TheWaveingOne/Projet-Final/Images/ard-dock-top.jpg

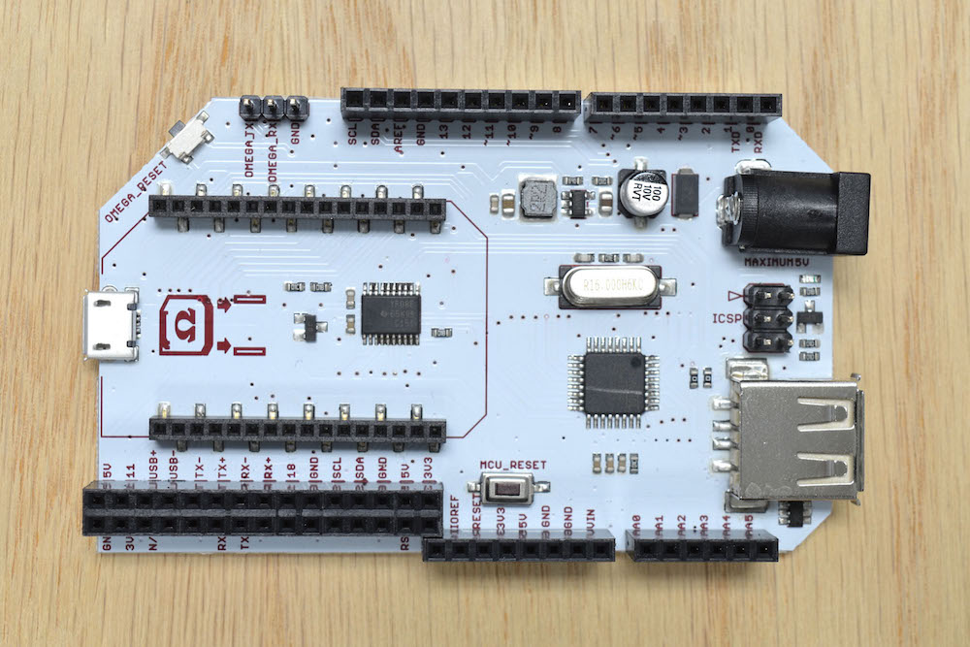
Images/ard-dock-top.jpg
