TheWaveingOne/Projet-Final/README.md

# Projet-Final
 Projet synthèse pour mon DEC
