TheWaveingOne/Projet-Final/PrésentationDessinMagnetique.pptx

## Contrôleur de dessin

Benoit Houle
Cegep de l’Outaouais
Technique du génie électrique
30 octobre 2019

## But

Remplacer le contrôleur
Changer la méthode de contrôle

## Utilités

Dessiner avec de l’encre magnétique
Linge avec lumières
Test sur du papier (plus rapide)

## Fonctionnalités

Contrôle de trois moteurs
Lecture de trois capteurs
Dessiner

## Exigence

Connexion réseau (wifi)
Doit pouvoir fonctionner sans surveillance
Alerte sonore quand la tâche est complété

## Contrainte

Milieu scolaire (bruit minimum)

Simplicité d’utilisation
