TheWaveingOne/Projet-Final/Eagle/CAM/Commandes.png

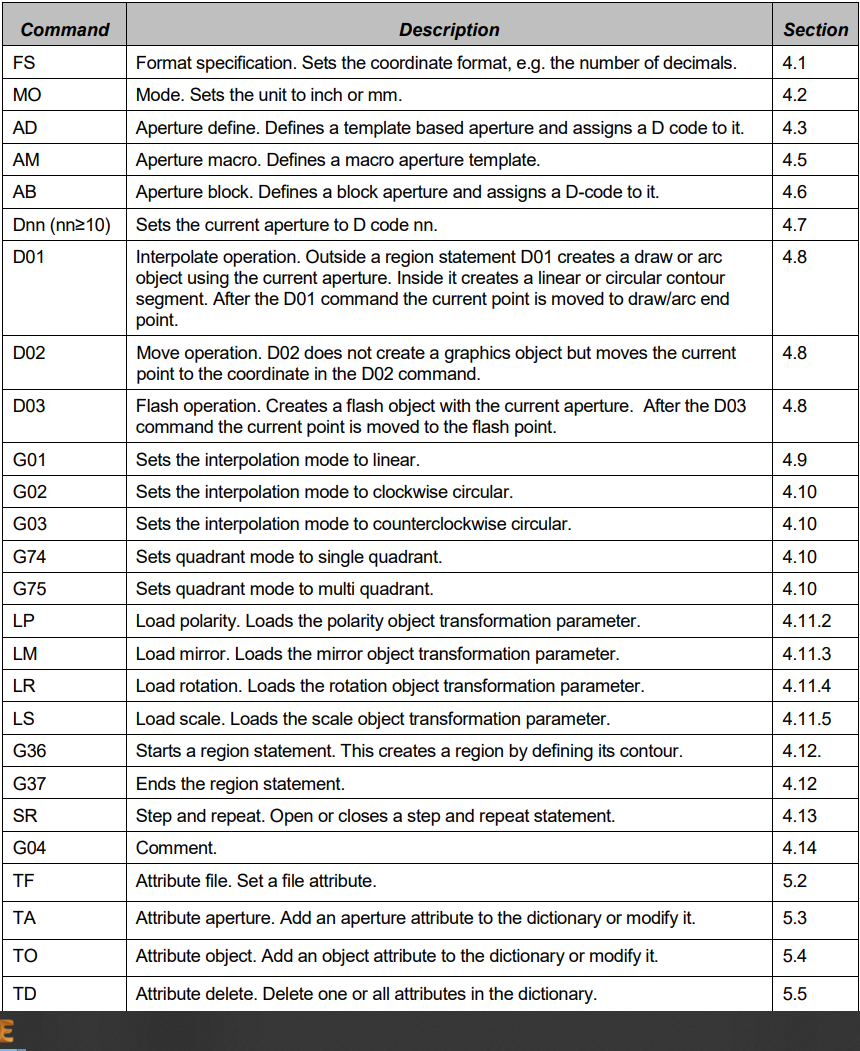
Eagle/CAM/Commandes.png
