TheWaveingOne/Projet-Final/Eagle/Controle_Des_Moteurs.png

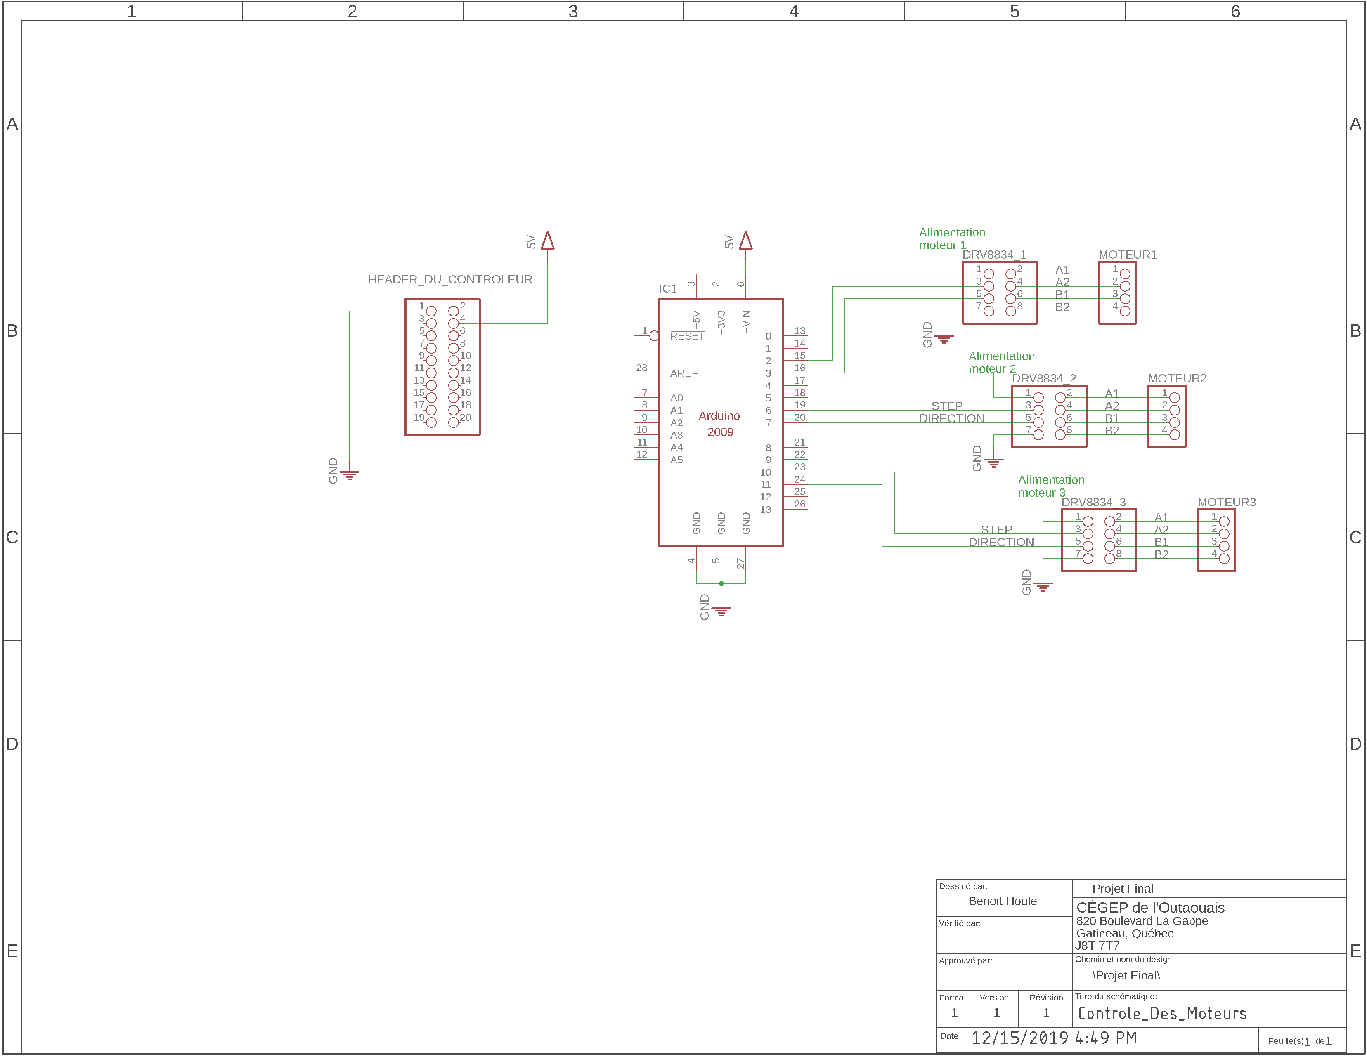
Eagle/Controle_Des_Moteurs.png
