TheWaveingOne/Projet-Final/Images/DRV8834 board pin.png

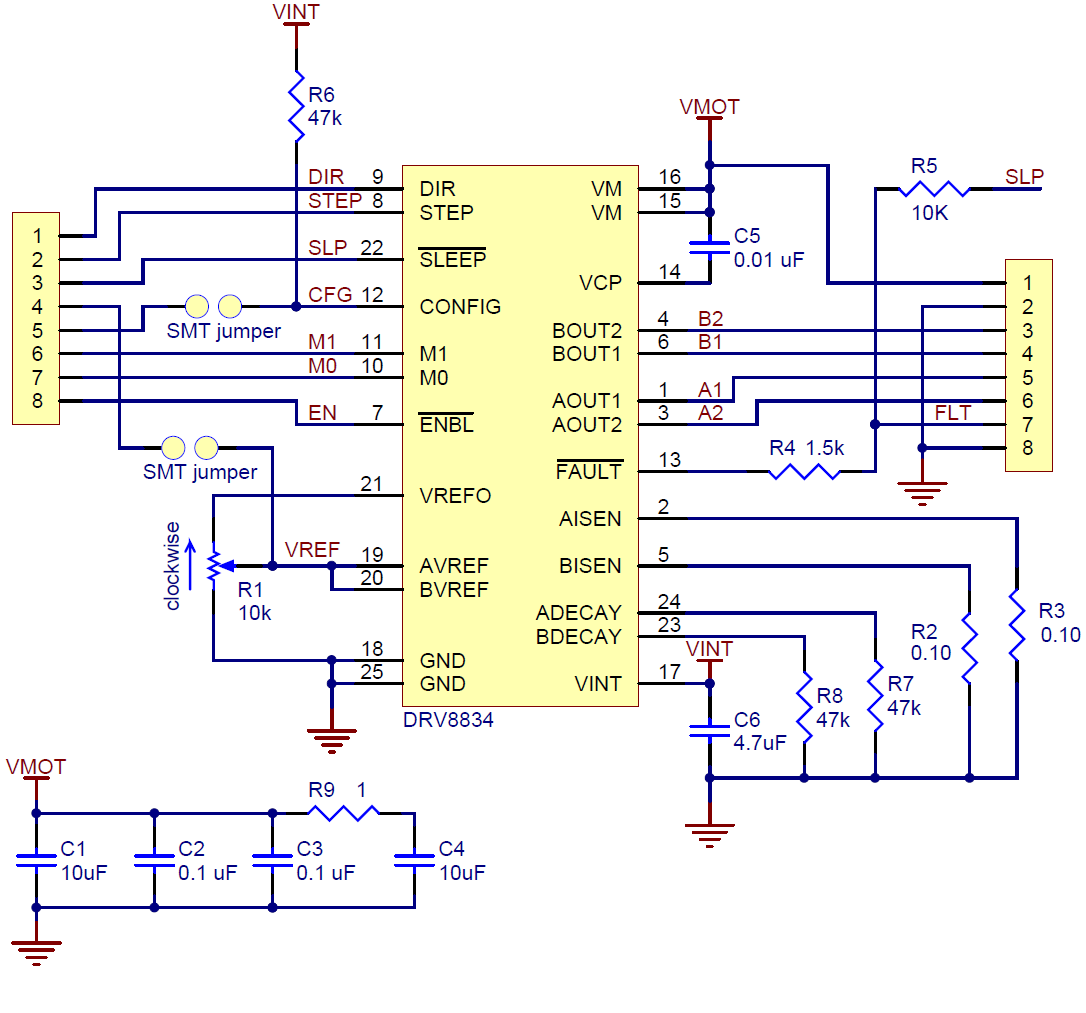
Images/DRV8834 board pin.png
