TheWaveingOne/Projet-Final/Images/DRV8834 exemple pin2.png

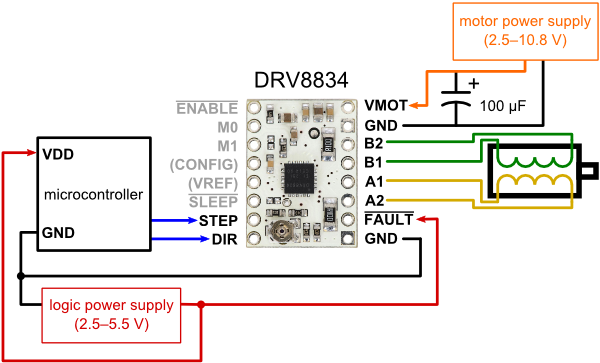
Images/DRV8834 exemple pin2.png
