TheWaveingOne/Projet-Final/Images/schematique.png

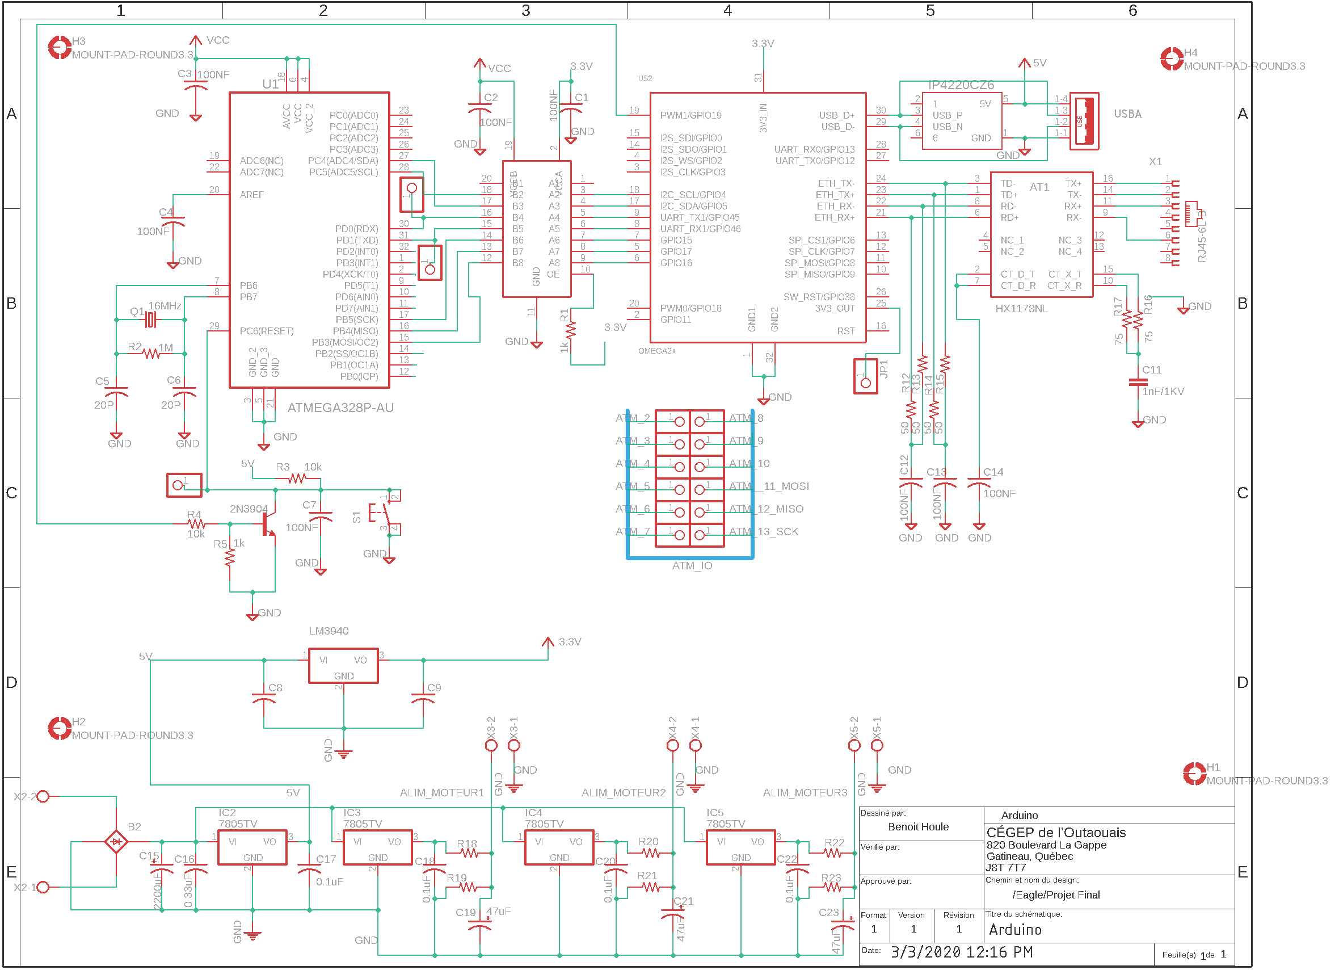
Images/schematique.png
