TheWaveingOne/Projet-Final/onion lib/Schemas electrique/5V.png

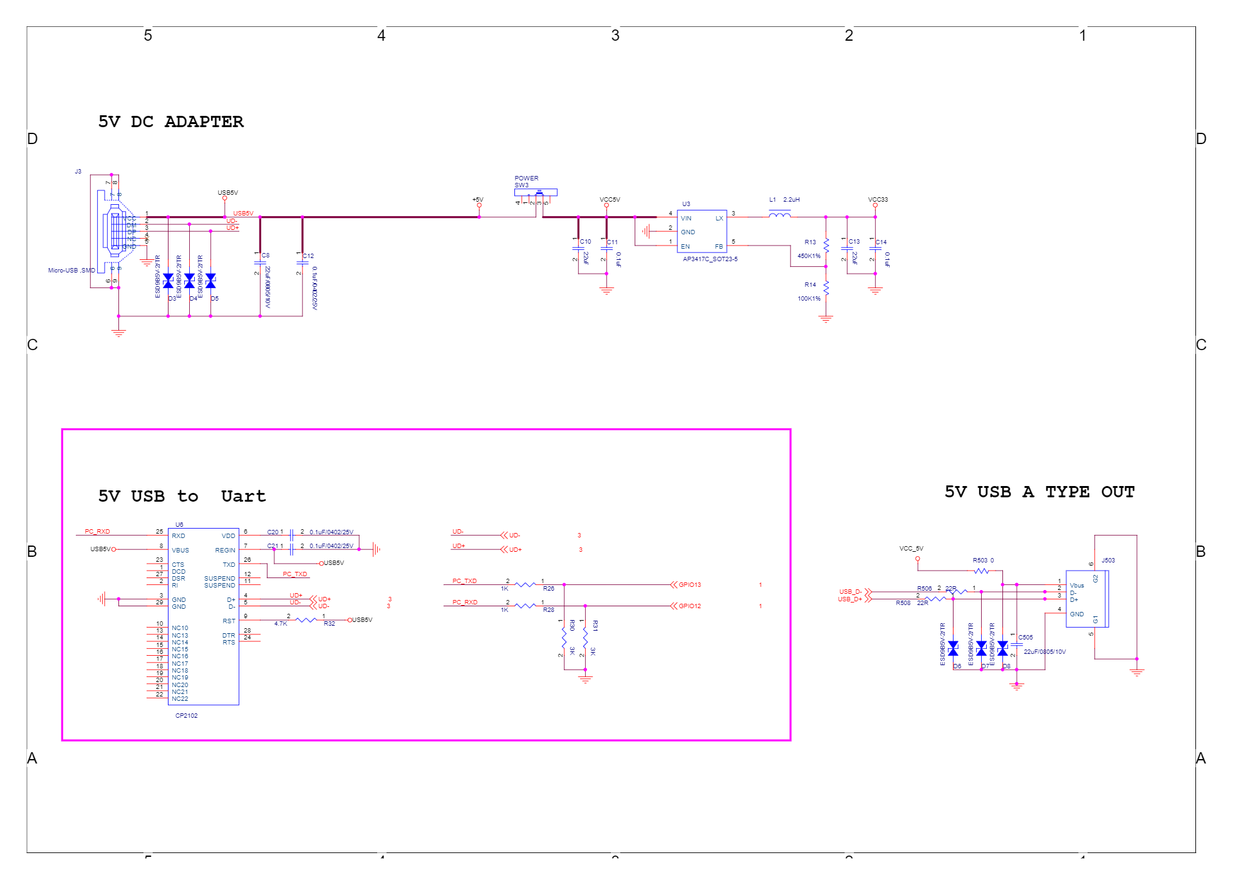
onion lib/Schemas electrique/5V.png
