TheWaveingOne/Projet-Final/onion lib/Schemas electrique/arduinodock2.png

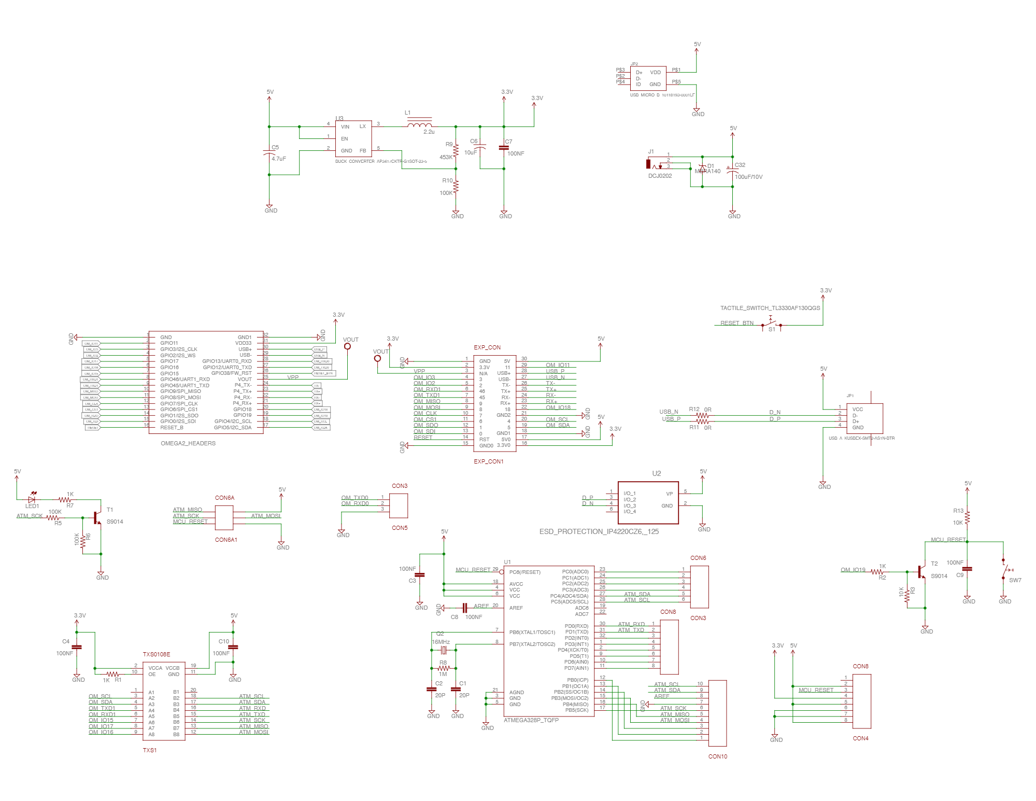
onion lib/Schemas electrique/arduinodock2.png
