TheWaveingOne/Projet-Final/onion lib/Schemas electrique/ethernet.png

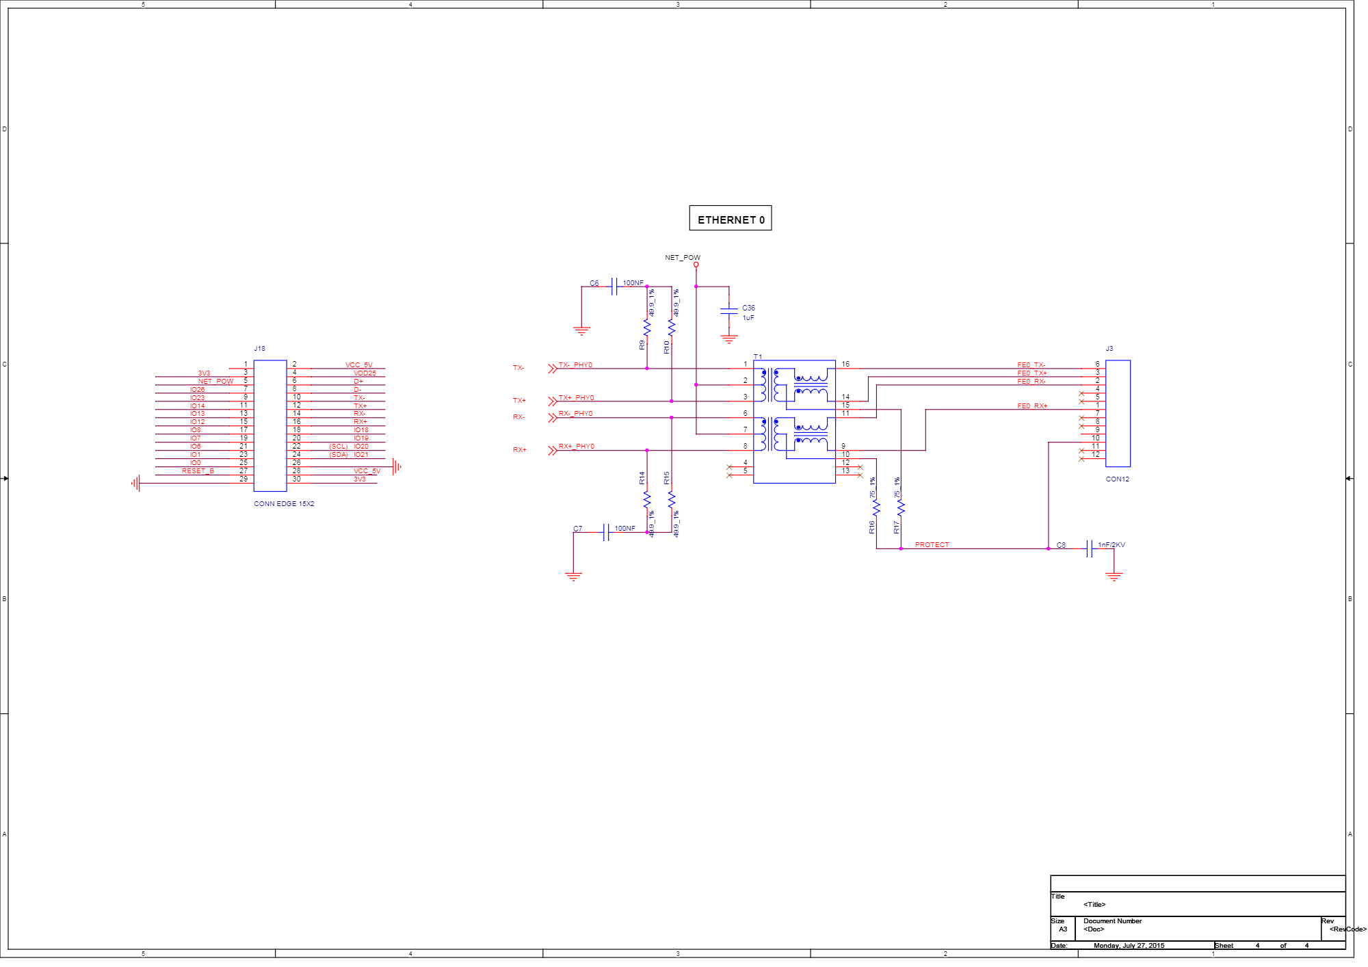
onion lib/Schemas electrique/ethernet.png
