TheWaveingOne/Projet-Final/onion lib/Schemas electrique/ethernet_2.png

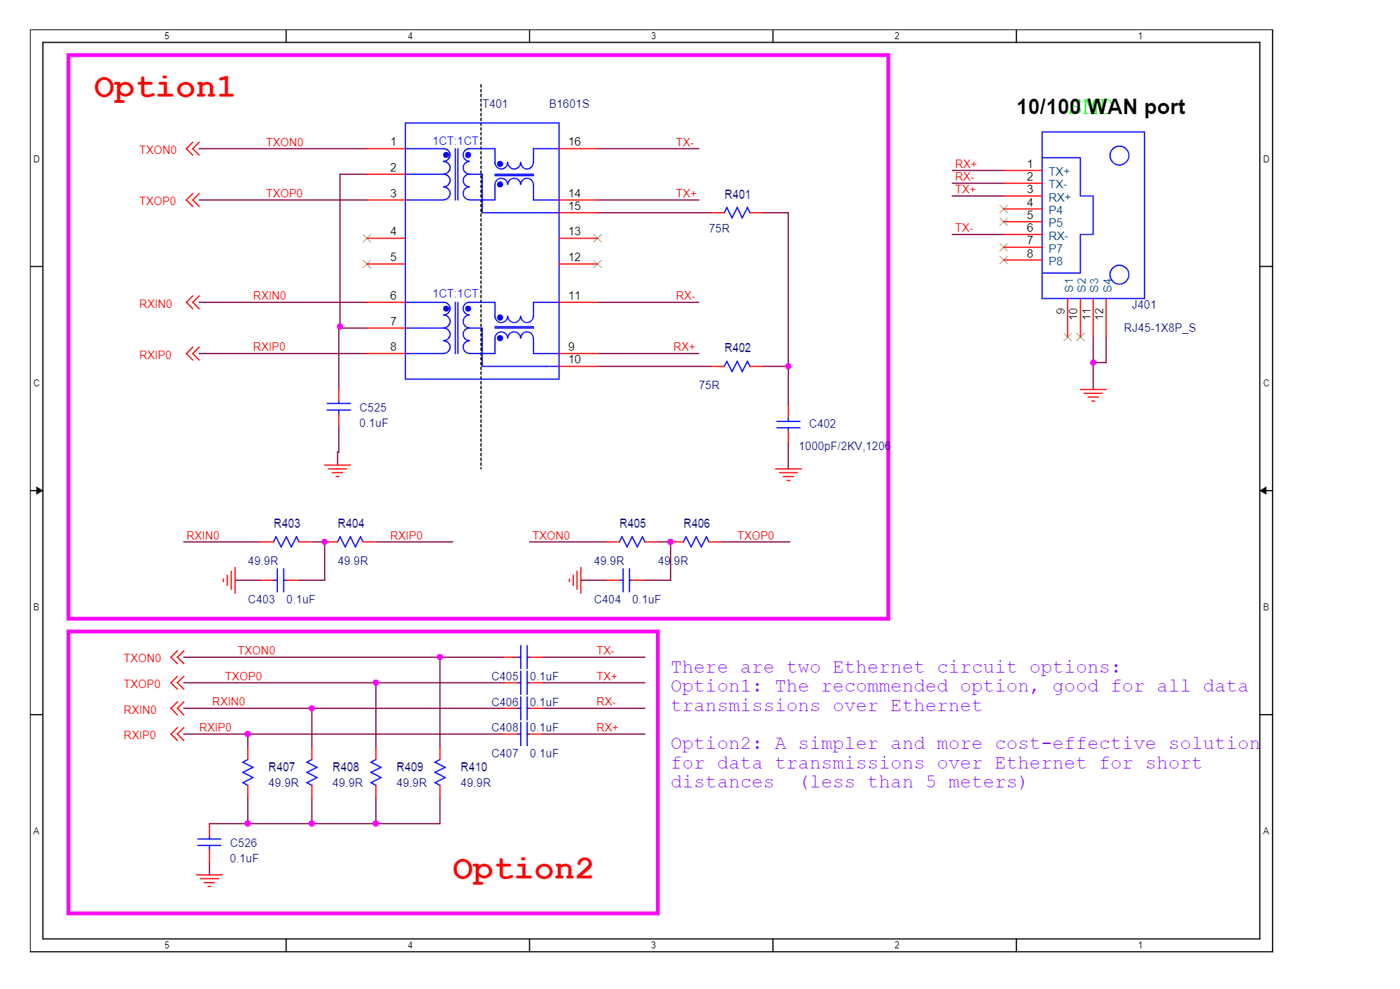
onion lib/Schemas electrique/ethernet_2.png
