TheWaveingOne/Projet-Final/onion lib/Schemas electrique/expensiondock2.png

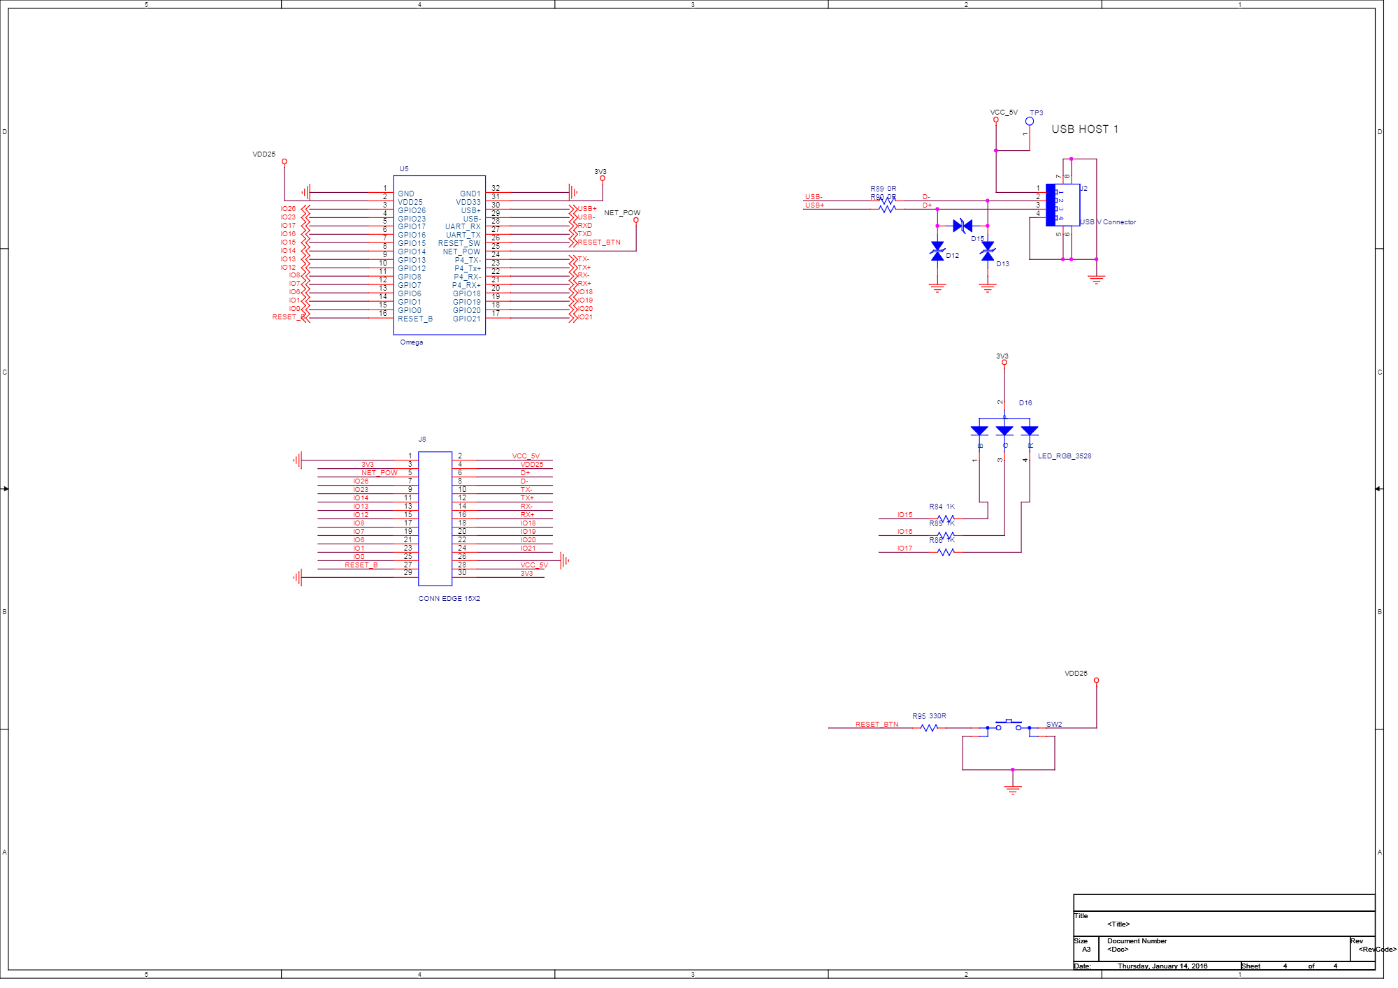
onion lib/Schemas electrique/expensiondock2.png
