TheWaveingOne/Projet-Final/onion lib/Schemas electrique/expensiondock.png

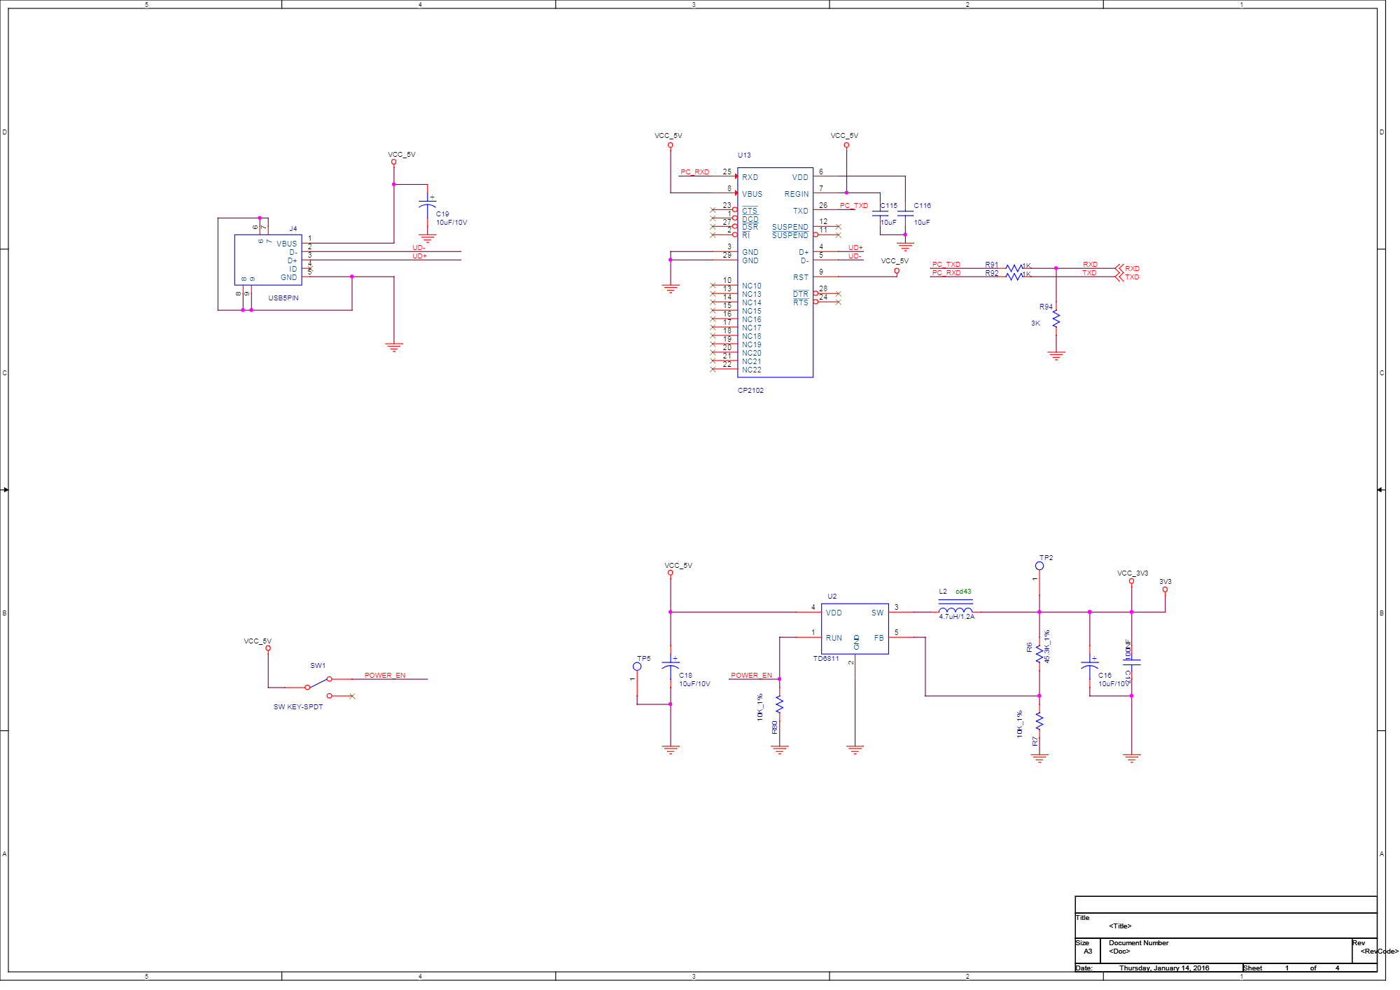
onion lib/Schemas electrique/expensiondock.png
