TheWaveingOne/Projet-Final/onion lib/Schemas electrique/General.png

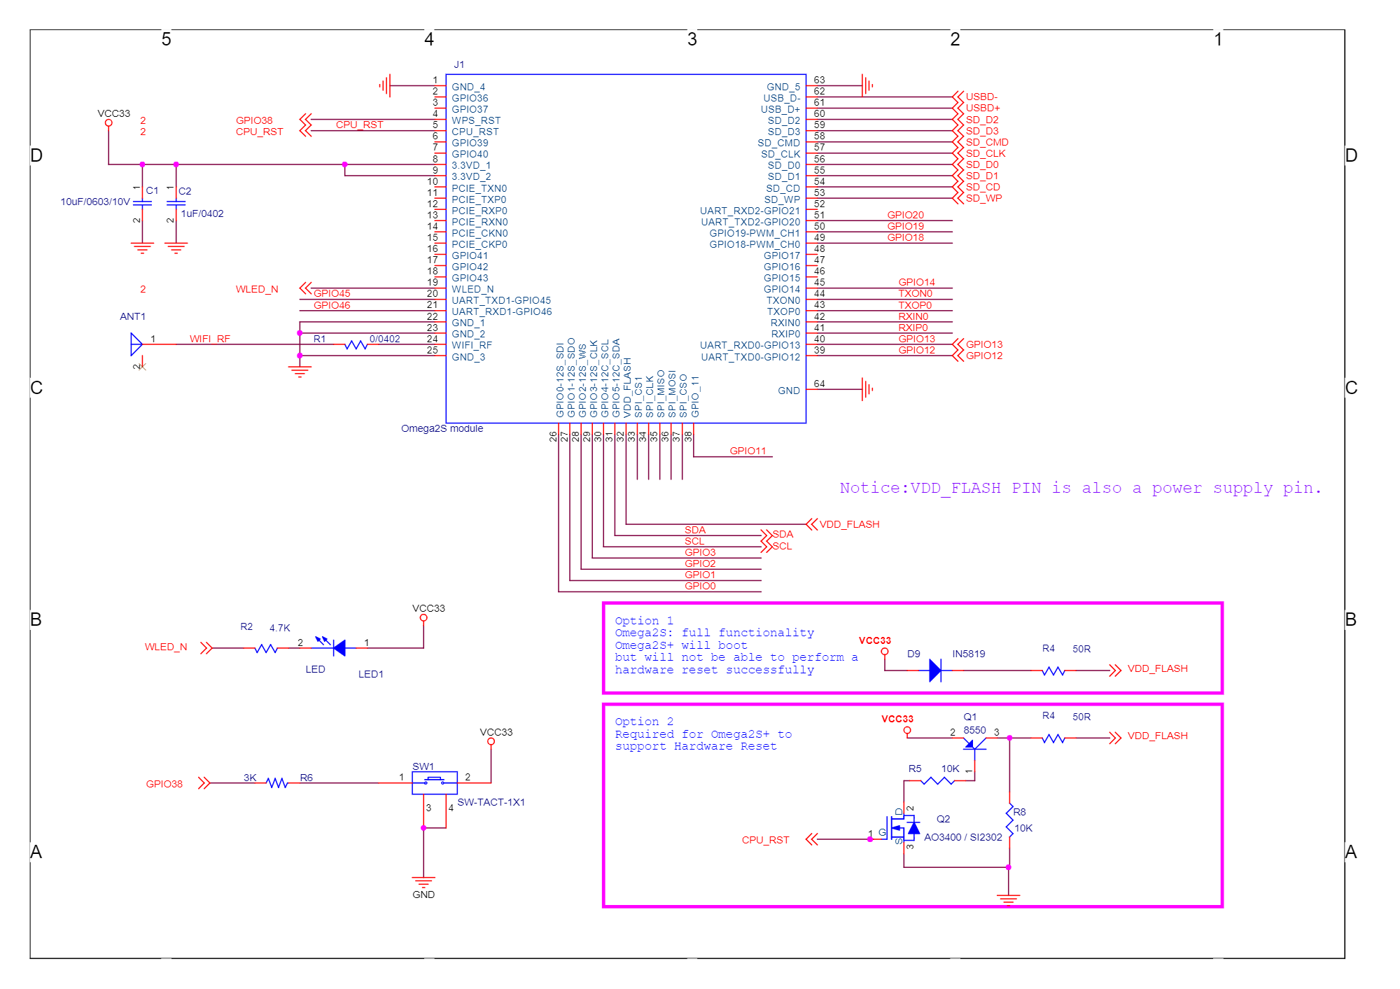
onion lib/Schemas electrique/General.png
