TheWaveingOne/Projet-Final/onion lib/Schemas electrique/gpsexpension.png

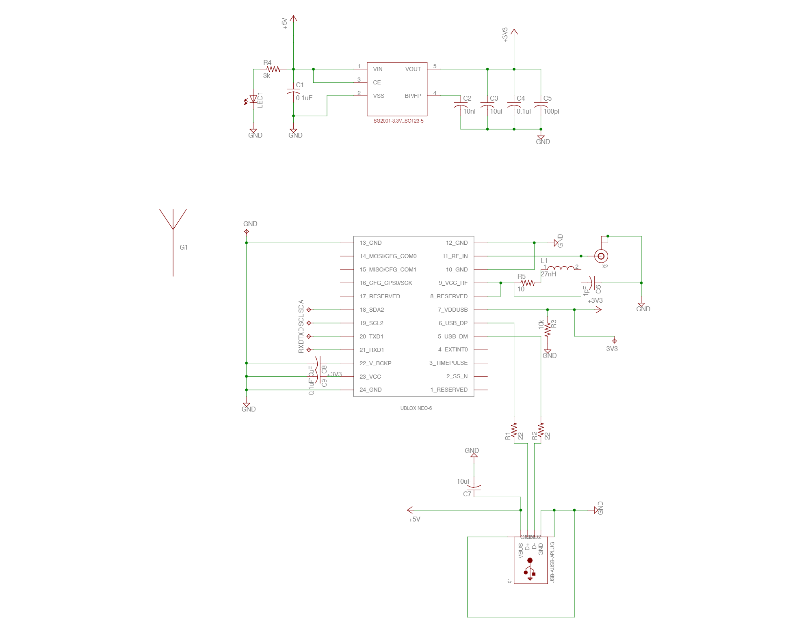
onion lib/Schemas electrique/gpsexpension.png
