TheWaveingOne/Projet-Final/onion lib/Schemas electrique/OLEDexpension.png

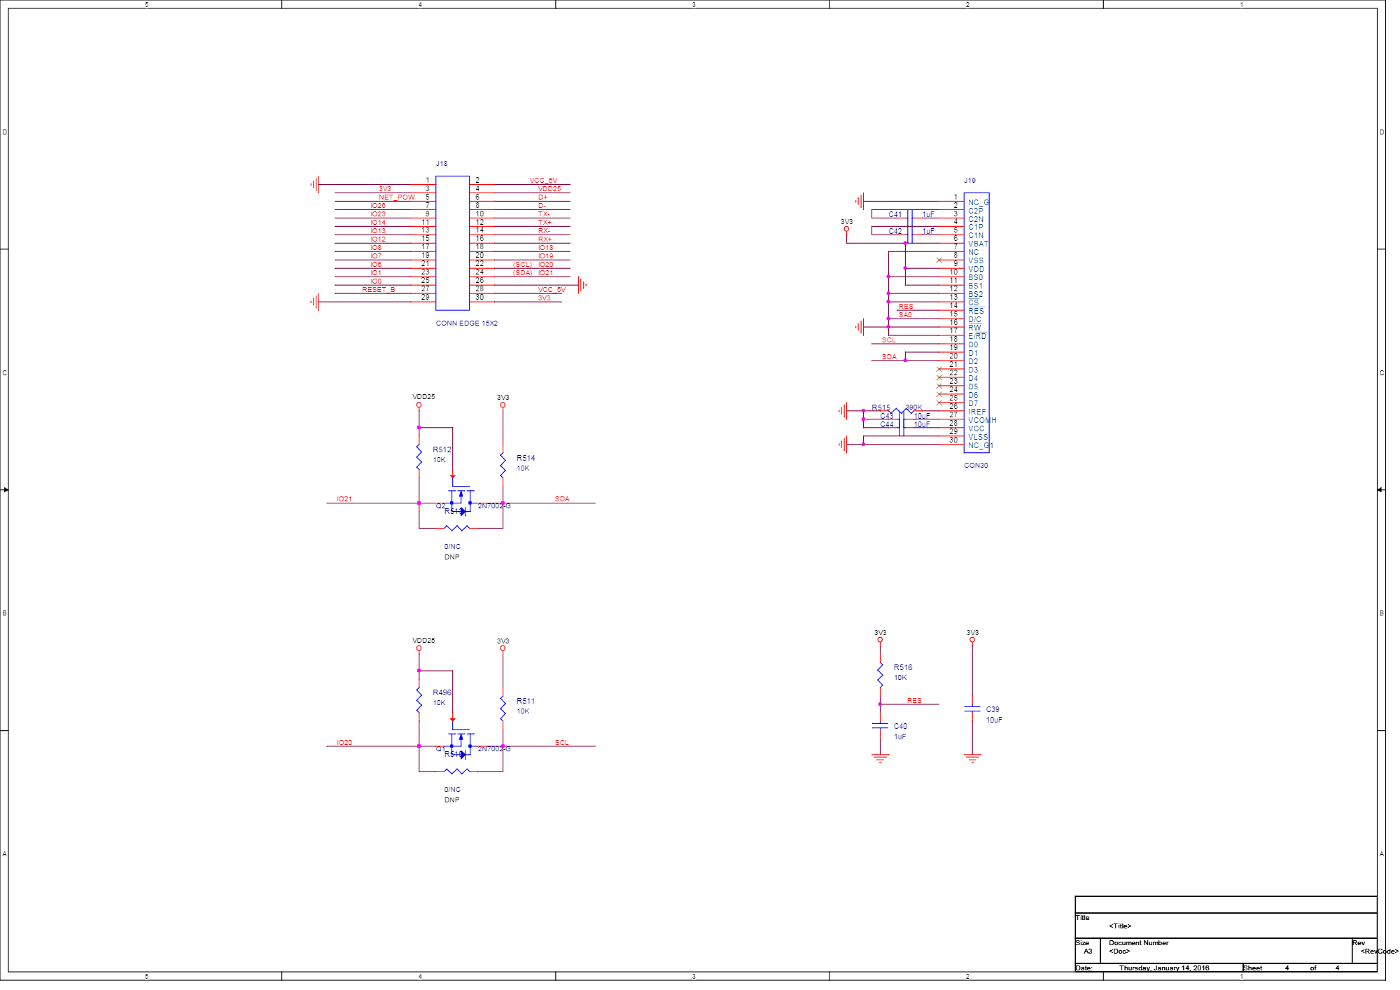
onion lib/Schemas electrique/OLEDexpension.png
