TheWaveingOne/Projet-Final/onion lib/Schemas electrique/relay.png

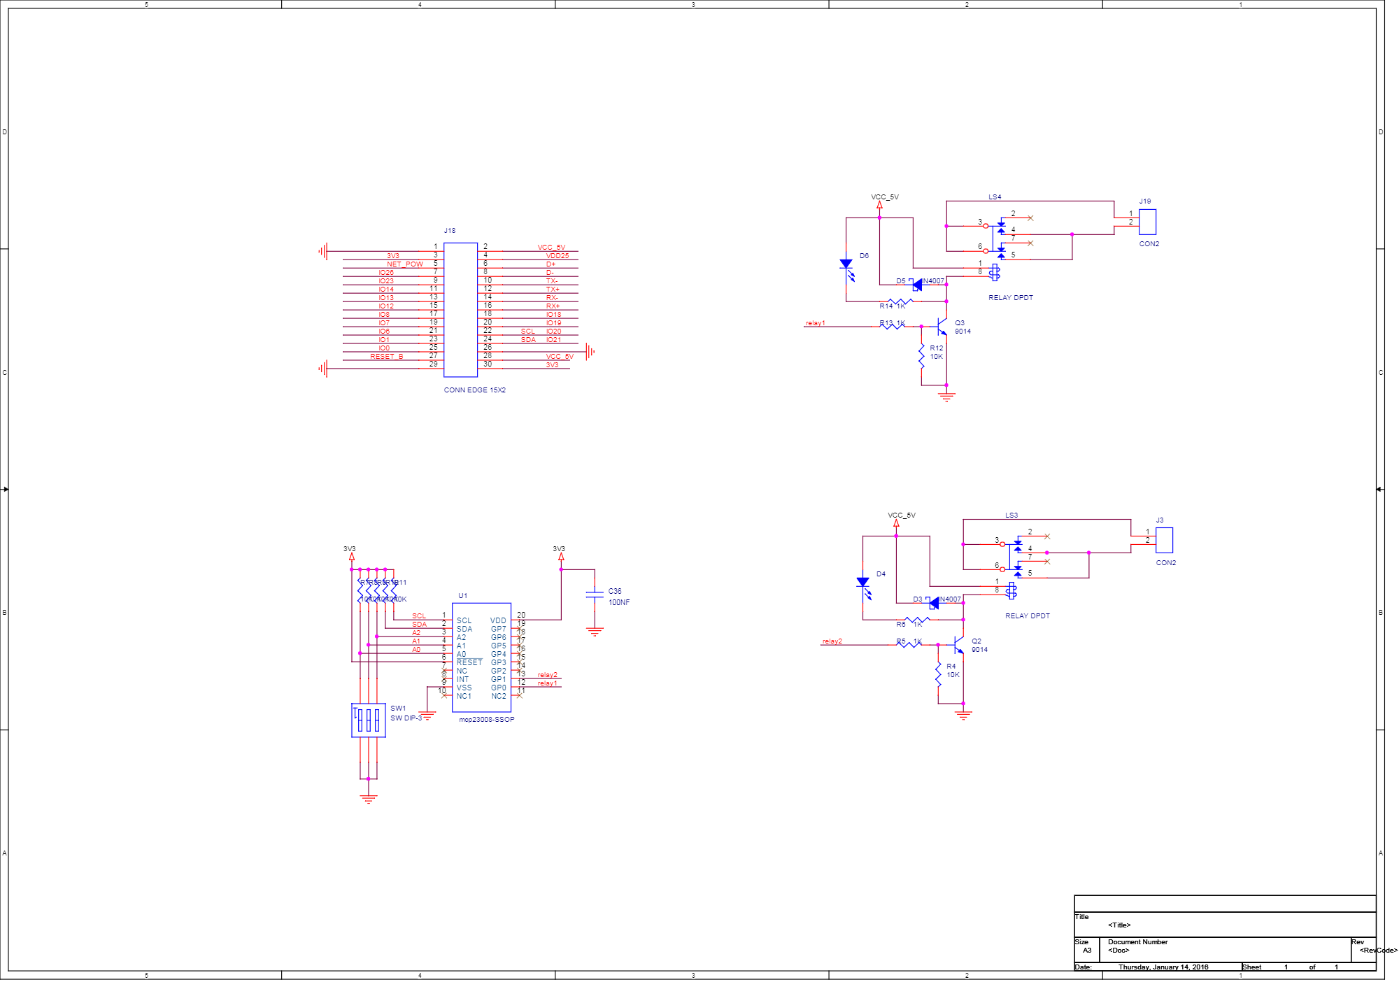
onion lib/Schemas electrique/relay.png
