TheWaveingOne/Projet-Final/Eagle/Tableaux.xlsx

Pièce | Numéro de pièce | Package | Description | Prix (CAD$)
HX1178NL | AT1 | SOP254P1283X647-16N | Signal Transformers 10/100Base-T SMD 1-Port | 10.1
IP4220CZ6 | IP4220CZ6 | DIODE_SOT457_1P7X3P1-M |  | 0.56
CRYSTALHC49S | Q1 | HC49/S | 16MHz CRYSTAL | 0.55
OMEGA2+ | O1 | OMEGA2 | Onion Omega2+ | 15.16
ATMEGA328P-AU | U1 | QFP80P900X900X120-32N | 8-bit Microcontroller | 2.76
USB_2P85-32003-00X-1 | USB | USB2 |  | 2.39
TXS0108E | U2 | TSSOP20 | 8-BIT BIDIRECTIONAL VOLTAGE-LEVEL TRANSLATOR | 0.73
RJ45-6L-B | X1 | RJ45-NO-SHIELD | CORCOM Modular RJ Jacks No Shield | 10.32
7805TV | IC2,IC3,IC4,IC5 | TO220V |  | 8.2
7824TV | LM3940 | TO220V |  | 2.07
Condensateurs & resistances | Valeur | Package
C1, C2, C3, C4, C7, C12, C13, C14 | 100NF | C0603K |  | 0.73
C5, C6 | 20P | C0603K |  | 0.9
C11 | 1nF/1KV | XC10B6 |  | 0.54
C15 | 2200uF | SANYO-OSCON |  | 1.16
C16 | 0.33uF | C0603K |  | 0.52
C17, C18, C20, C22 | 0.1uF | C0603K |  | 0.66
C19, C21, C23 | 47uF | SANYO-OSCON |  | 0.99
R1 | 1k | M1206 |  | 0.18
R2 | 1M | M1206 |  | 0.19
R3, R4 | 10k | M1206 |  | 0.36
R5 | 1k | M3216 |  | 2.23
R12, R13, R14, R15 | 50 | M1206 |  | 3.85
R16, R17 | 75 | M1206 |  | 0.66
R18, R20, R22 | 0.82 | 0309/10 |  | 1.54
R19, R21, R23 | 3.72 | 0309/10 |  | 1.28
 |  |  | Total | 68.63
