TheWaveingOne/Projet-Final/Images/step&microstep.png

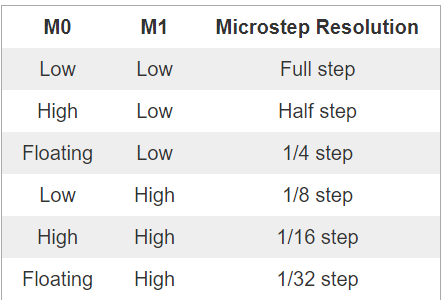
Images/step&microstep.png
