TheWaveingOne/Projet-Final/Eagle/Arduino.brd

## EAGLE design Eagle/Arduino.brd (2020-07-23)

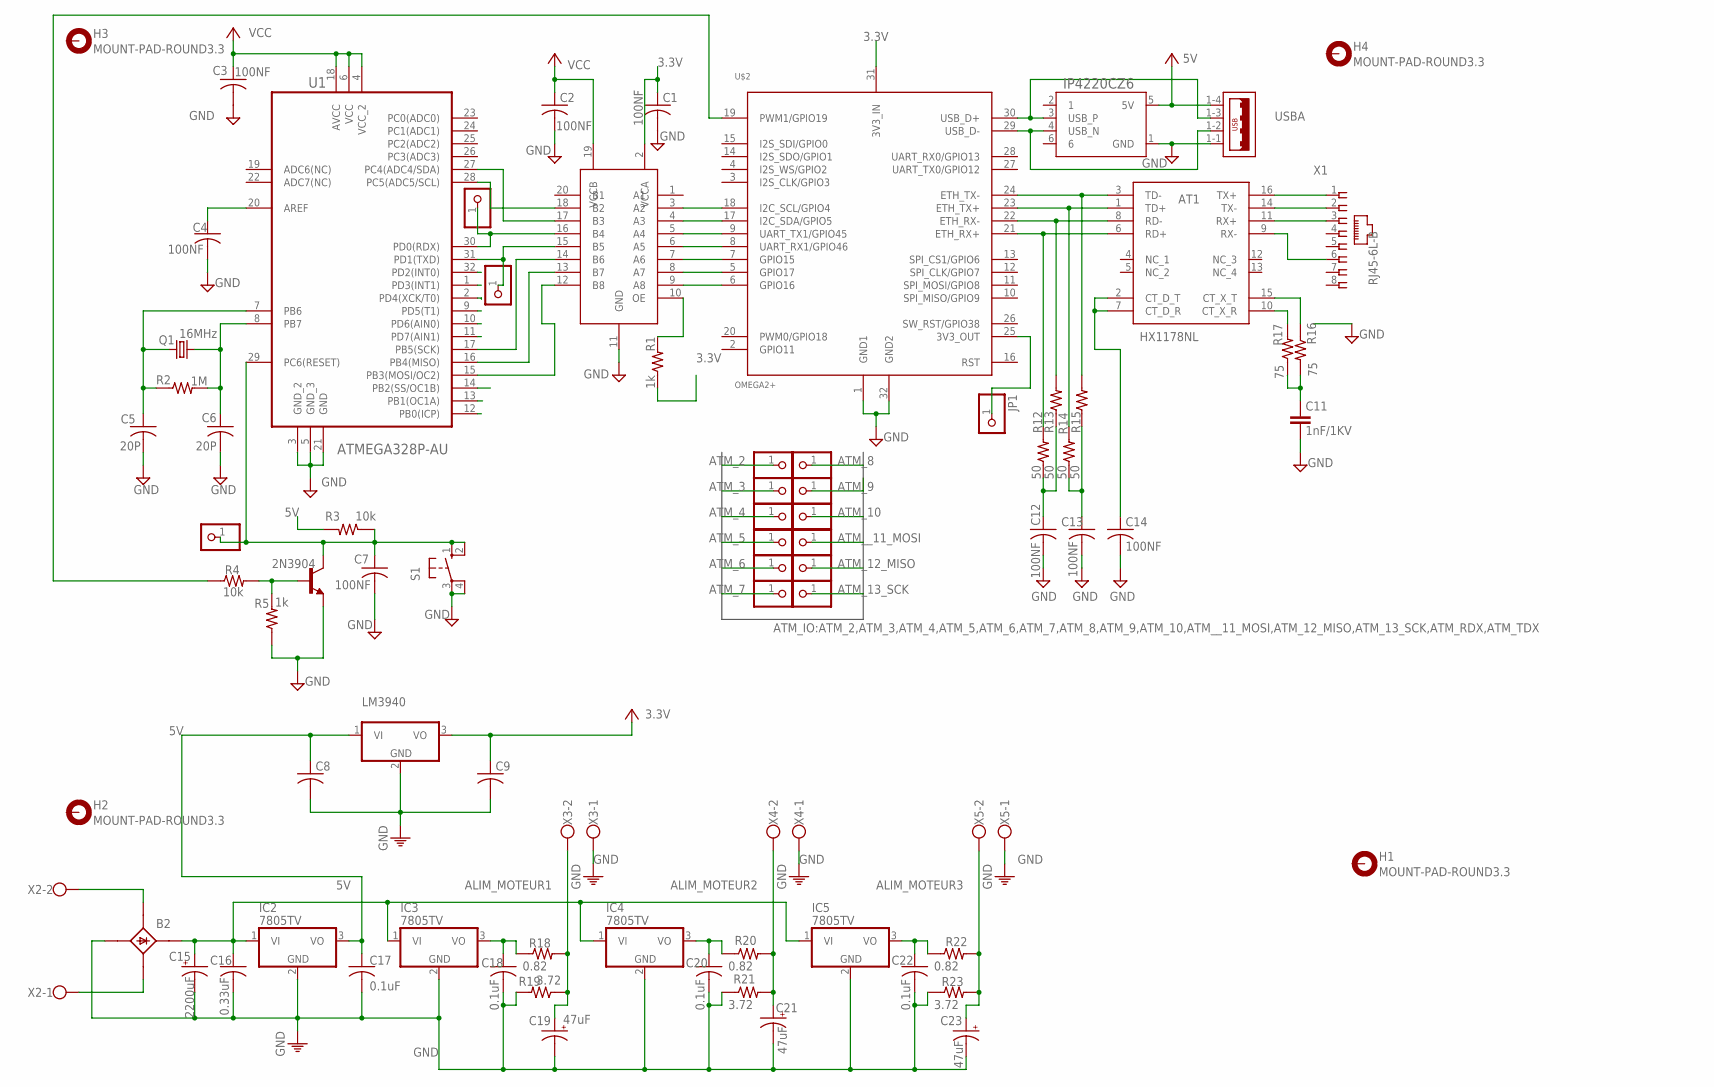
[picture p32: schematic Arduino.sch]

Parts:
AT1: HX1178NL; SOP254P1283X647-16N
B2: B25A-
C1, C2, C3, C4, C7, C12, C13, C14: 100NF; C0603K
C5, C6: 20P; C0603K
C8, C9: CENPC1206K; C1206K
C11: 1nF/1KV; XC10B6
C15: 2200uF; SANYO-OSCON_B'
C16: 0.33uF; C0603K
C17, C18, C20, C22: 0.1uF; C0603K
C19, C21, C23: 47uF; SANYO-OSCON_B'
FRAME1: CARTOUCHE_TGÉ; CARTOUCHE
H1, H2, H3, H4: MOUNT-PAD-ROUND3.3; 3,3-PAD
IC2, IC3, IC4, IC5: 7805TV; TO220V
IP4220CZ6: IP4220CZ6,125DIODE_SOT457_1P7X3P1-M; DIODE_SOT457_1P7X3P1-M
JP1, JP2, JP3, JP4, JP5, JP6, JP7, JP8, JP9, JP10, JP11, JP12, JP13, JP14, JP15, JP16: PINHD-1X1; 1X01
LM3940: 7824TV; TO220V
Q1: 16MHz; HC49/S
R1: 1k; M1206
R2: 1M; M1206
R3, R4: 10k; M1206
R5: 1k; M3216
R12, R13, R14, R15: 50; M1206
R16, R17: 75; M1206
R18, R20, R22: 0.82; 0309/10
R19, R21, R23: 3.72; 0309/10
S1: 10-XX; B3F-10XX
U1: ATMEGA328P-AU; QFP80P900X900X120-32N
U$1: TXS0108E; TSSOP20
U$2: OMEGA2+; OMEGA2_PADS
USB: USB_2P85-32003-00X-1; USB2
VERIFIER_TYPE: 2N3904; TO92
X1: RJ45-6L-B; RJ45-NO-SHIELD
X2, X3, X4, X5: W237-102

Connections:
3.3V: C1.1, C9.1, LM3940.3 (VO), R1.1, U$1.2 (VCCA), U$2.31 (3V3_IN)
5V: C2.1, C3.1, C8.1, C17.1, IC2.3 (VO), IP4220CZ6.5 (5V), LM3940.1 (VI), R3.2, U1.4 (VCC_2), U1.6 (VCC), U1.18 (AVCC), U$1.19 (VCCB), USB.1-4 (4)
ALIM_MOTEUR1: C19.+, R18.2, R19.1, X3.2
ALIM_MOTEUR2: C21.+, R20.2, R21.2, X4.2
ALIM_MOTEUR3: C23.+, R22.2, R23.2, X5.2
ATM_2: JP3.1, U1.32 (PD2(INT0))
ATM_3: JP4.1, U1.1 (PD3(INT1))
ATM_4: JP7.1, U1.2 (PD4(XCK/T0))
ATM_5: JP8.1, U1.9 (PD5(T1))
ATM_6: JP9.1, U1.10 (PD6(AIN0))
ATM_7: JP10.1, U1.11 (PD7(AIN1))
ATM_8: JP11.1, U1.12 (PB0(ICP))
ATM_9: JP12.1, U1.13 (PB1(OC1A))
ATM_10: JP13.1, U1.14 (PB2(SS/OC1B))
ATM_12_MISO: JP15.1, U1.16 (PB4(MISO)), U$1.13 (B7)
ATM_13_SCK: JP16.1, U1.17 (PB5(SCK)), U$1.14 (B6)
ATM_RDX: JP5.1, U1.30 (PD0(RDX)), U$1.16 (B4)
ATM_SCI: U1.28 (PC5(ADC5/SCL)), U$1.18 (B2)
ATM_SDA: U1.27 (PC4(ADC4/SDA)), U$1.17 (B3)
ATM_TDX: JP6.1, U1.31 (PD1(TXD)), U$1.15 (B5)
ATM__11_MOSI: JP14.1, U1.15 (PB3(MOSI/OC2)), U$1.12 (B8)
GND: B2.-1 (-), C1.2, C2.2, C3.2, C4.2, C5.2, C6.2, C7.2, C8.2, C9.2, C11.2, C12.2, C13.2, C14.2, C15.-, C16.2, C17.2, C18.2, C19.-, C20.2, C21.-, C22.2, C23.-, IC2.2 (GND), IC3.2 (GND), IC4.2 (GND), IC5.2 (GND), IP4220CZ6.1 (GND), LM3940.2 (GND), R5.1, R19.2, R21.1, R23.1, S1.3, S1.4 (P1), U1.3 (GND_2), U1.5 (GND_3), U1.21 (GND), U$1.11 (GND), U$2.1 (GND1), U$2.32 (GND2), USB.1-1 (1), VERIFIER_TYPE.3 (E), X3.1, X4.1, X5.1
MCU_RESET: C7.1, JP2.1, R3.1, S1.1 (S), S1.2 (S1), U1.29 (PC6(RESET)), VERIFIER_TYPE.1 (C)
unnamed: R1.2, U$1.10 (OE)
unnamed: C4.1, U1.20 (AREF)
unnamed: C6.1, Q1.2, R2.2, U1.8 (PB7)
unnamed: C5.1, Q1.1, R2.1, U1.7 (PB6)
unnamed: C11.1, R16.2, R17.1
unnamed: AT1.2 (CT_D_T), AT1.7 (CT_D_R), C14.1
unnamed: AT1.15 (CT_X_T), R16.1
unnamed: AT1.10 (CT_X_R), R17.2
unnamed: R4.1, U$2.19 (PWM1/GPIO19)
unnamed: B2.AC1- (AC1), X2.2
unnamed: B2.AC2- (AC2), X2.1
unnamed: C18.1, IC3.3 (VO), R18.1
unnamed: C20.1, IC4.3 (VO), R20.1
unnamed: C22.1, IC5.3 (VO), R22.1
unnamed: R4.2, R5.2, VERIFIER_TYPE.2 (B)
unnamed: IP4220CZ6.3 (USB_P), U$2.30 (USB_D+), USB.1-3 (3)
unnamed: IP4220CZ6.4 (USB_N), U$2.29 (USB_D-), USB.1-2 (2)
unnamed: AT1.3 (TD-), R15.2, U$2.24 (ETH_TX-)
unnamed: AT1.1 (TD+), R14.2, U$2.23 (ETH_TX+)
unnamed: AT1.8 (RD-), R13.2, U$2.22 (ETH_RX-)
unnamed: AT1.6 (RD+), R12.2, U$2.21 (ETH_RX+)
unnamed: AT1.16 (TX+), X1.1
unnamed: AT1.14 (TX-), X1.2
unnamed: AT1.11 (RX+), X1.3
unnamed: AT1.9 (RX-), X1.6
unnamed: C12.1, R12.1, R13.1
unnamed: C13.1, R14.1, R15.1
OM_IO15: U$1.7 (A6), U$2.7 (GPIO15)
OM_IO16: U$1.9 (A8), U$2.6 (GPIO16)
OM_IO17: U$1.8 (A7), U$2.5 (GPIO17)
OM_RXD1: U$1.6 (A5), U$2.8 (UART_RX1/GPIO46)
OM_SCI: U$1.3 (A2), U$2.18 (I2C_SCL/GPIO4)
OM_SDA: U$1.4 (A3), U$2.17 (I2C_SDA/GPIO5)
OM_TXD1: U$1.5 (A4), U$2.9 (UART_TX1/GPIO45)
TP_3.3_OMEGA: JP1.1, U$2.25 (3V3_OUT)
VIN_7805: B2.+1 (+), C15.+, C16.1, IC2.1 (VI), IC3.1 (VI), IC4.1 (VI), IC5.1 (VI)

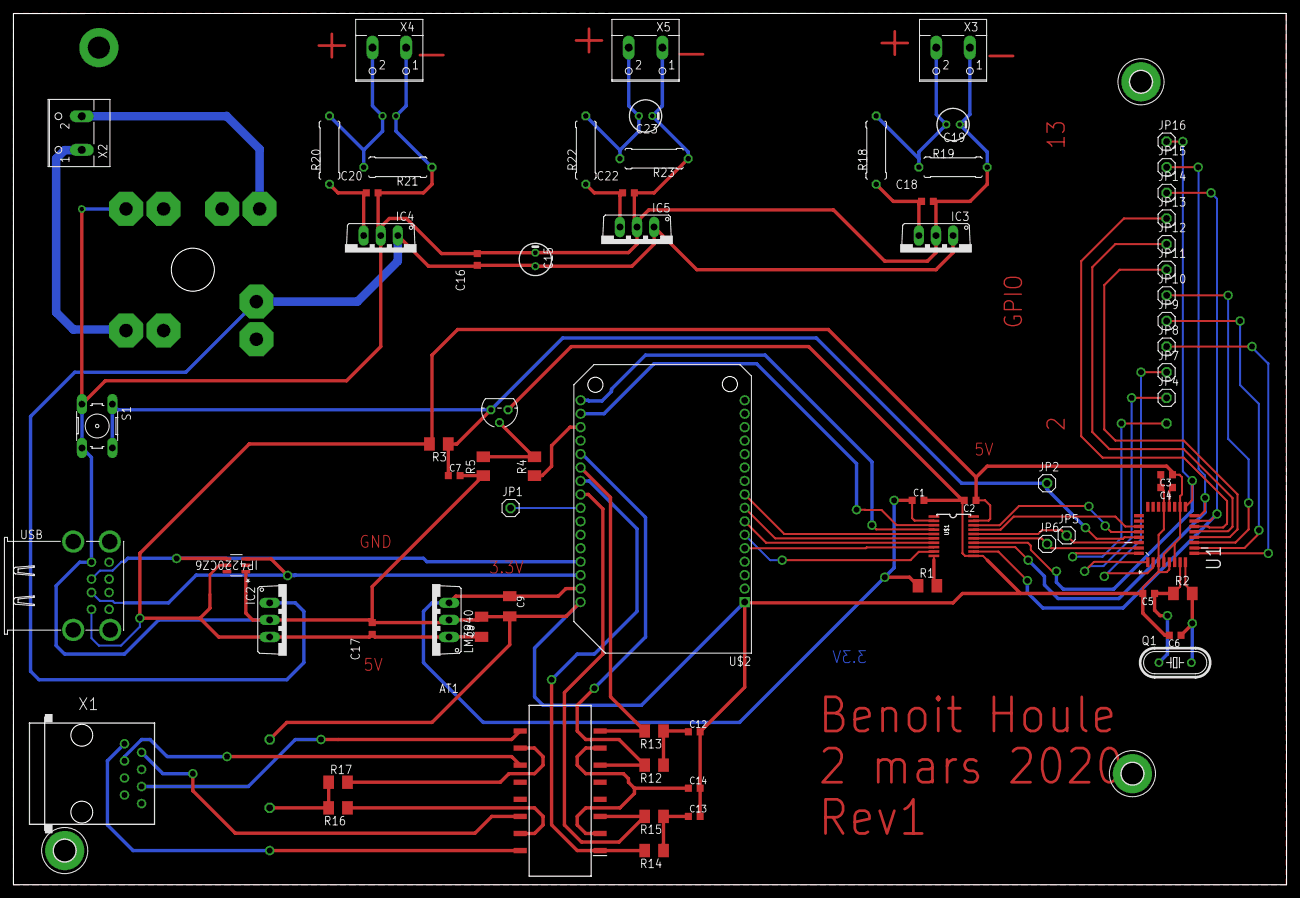
[picture p33: board Arduino.brd from above]

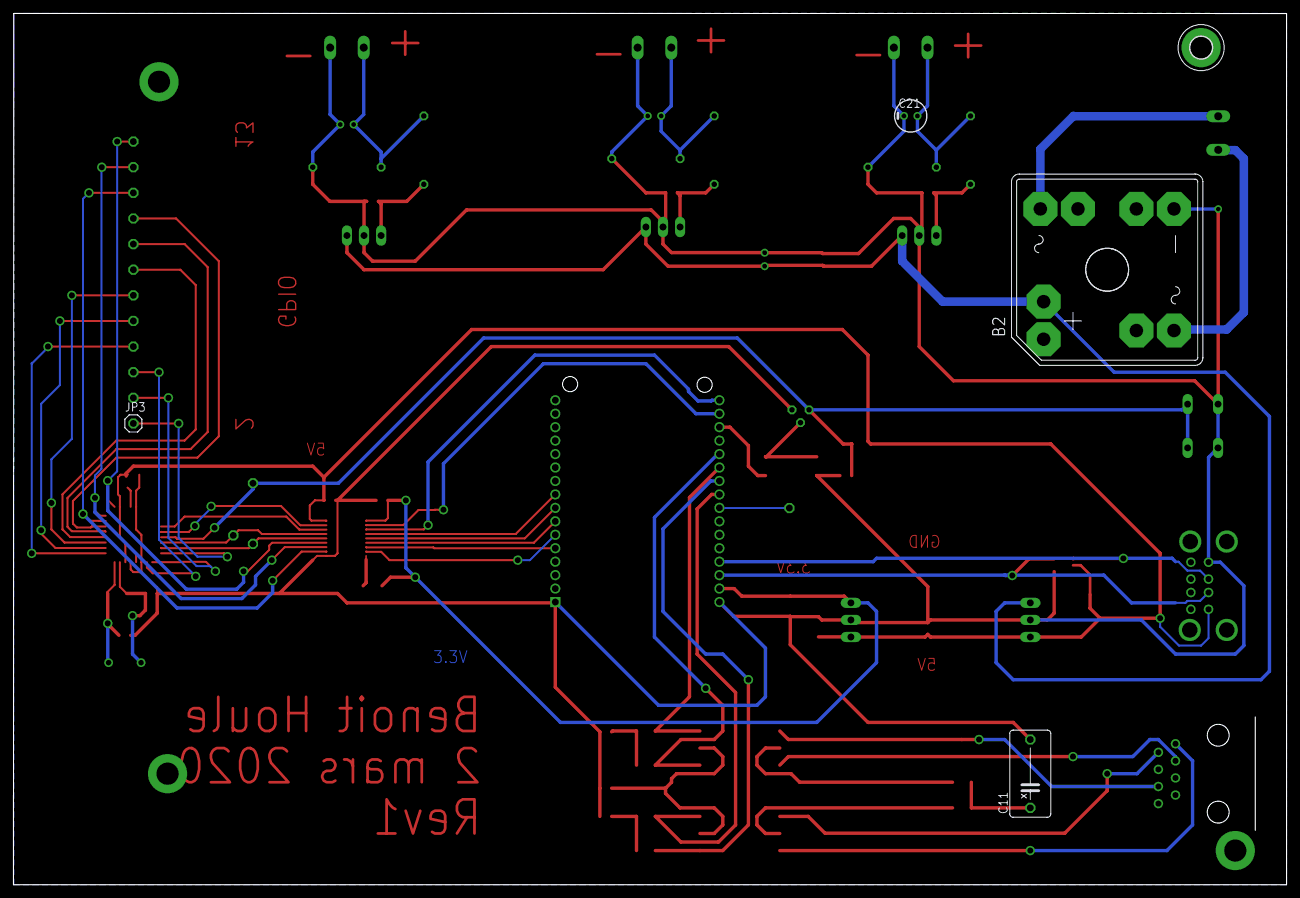
[picture p34: board Arduino.brd from below]

Board: 2 copper layers, 189.3 x 129.5 mm, 80 parts (5 on the bottom side), 59 nets.
