TheWaveingOne/Projet-Final/Code/arduino/StepperDriver-master/examples/MultiAxis/MultiAxis.ino

/*
 * Multi-motor control (experimental)
 *
 * Move two or three motors at the same time.
 * This module is still work in progress and may not work well or at all.
 *
 * Copyright (C)2017 Laurentiu Badea
 *
 * This file may be redistributed under the terms of the MIT license.
 * A copy of this license has been included with this distribution in the file LICENSE.
 */
#include <Arduino.h>
#include "BasicStepperDriver.h"
#include "MultiDriver.h"
#include "SyncDriver.h"

// Motor steps per revolution. Most steppers are 200 steps or 1.8 degrees/step
#define MOTOR_STEPS 200
// Target RPM for X axis motor
#define MOTOR_X_RPM 30
// Target RPM for Y axis motor
#define MOTOR_Y_RPM 90

// X motor
#define DIR_X 2
#define STEP_X 3

// Y motor
#define DIR_Y 6
#define STEP_Y 7

// If microstepping is set externally, make sure this matches the selected mode
// 1=full step, 2=half step etc.
#define MICROSTEPS 32

// 2-wire basic config, microstepping is hardwired on the driver
// Other drivers can be mixed and matched but must be configured individually
BasicStepperDriver stepperX(MOTOR_STEPS, DIR_X, STEP_X);
BasicStepperDriver stepperY(MOTOR_STEPS, DIR_Y, STEP_Y);

// Pick one of the two controllers below
// each motor moves independently, trajectory is a hockey stick
// MultiDriver controller(stepperX, stepperY);
// OR
// synchronized move, trajectory is a straight line
SyncDriver controller(stepperX, stepperY);

void setup() {

    //microstepping
    pinMode(4, OUTPUT);
    pinMode(5, OUTPUT);
    pinMode(8, OUTPUT);
    pinMode(9, OUTPUT);    
    digitalWrite(4, LOW); 
    digitalWrite(5, LOW); 
    digitalWrite(8, LOW); 
    digitalWrite(9, LOW); 

    
    /*
     * Set target motors RPM.
     */
    stepperX.begin(MOTOR_X_RPM, MICROSTEPS);
    stepperY.begin(MOTOR_Y_RPM, MICROSTEPS);
    // if using enable/disable on ENABLE pin (active LOW) instead of SLEEP uncomment next two lines
    // stepperX.setEnableActiveState(LOW);
    // stepperY.setEnableActiveState(LOW);
}

void loop() {

    controller.rotate(90*5, 60*15);
    delay(1000);
    controller.rotate(-90*5, -30*15);
    delay(1000);
    controller.rotate(0, -30*15);
    delay(10000);
}
